michaelrommel/nightliner/images/nightliner-left-noacryl.png

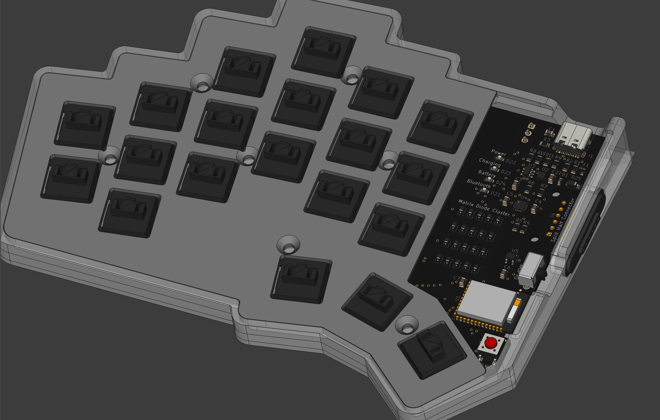
images/nightliner-left-noacryl.png
