michaelrommel/nightliner/images/nightliner-left-pcb-in-case.png

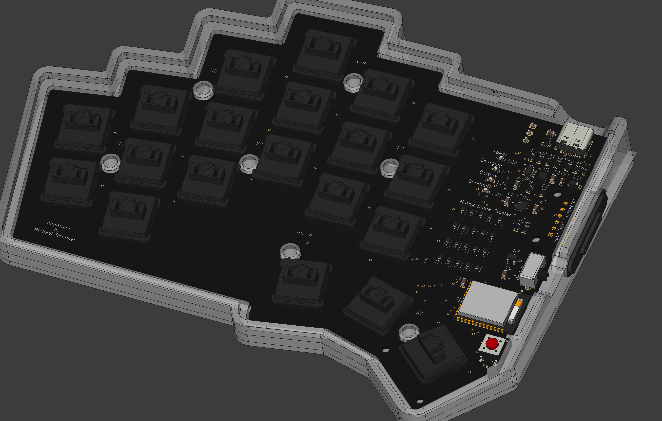
images/nightliner-left-pcb-in-case.png
