michaelrommel/nightliner/images/nightliner-left-pcb-underside.png

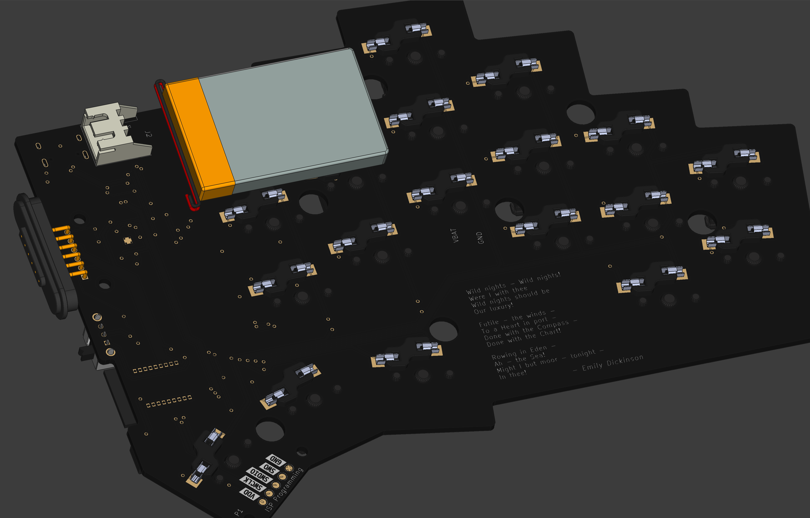
images/nightliner-left-pcb-underside.png
