michaelrommel/nightliner/3dmodels/pogo-connector-female-6-right.FCStd

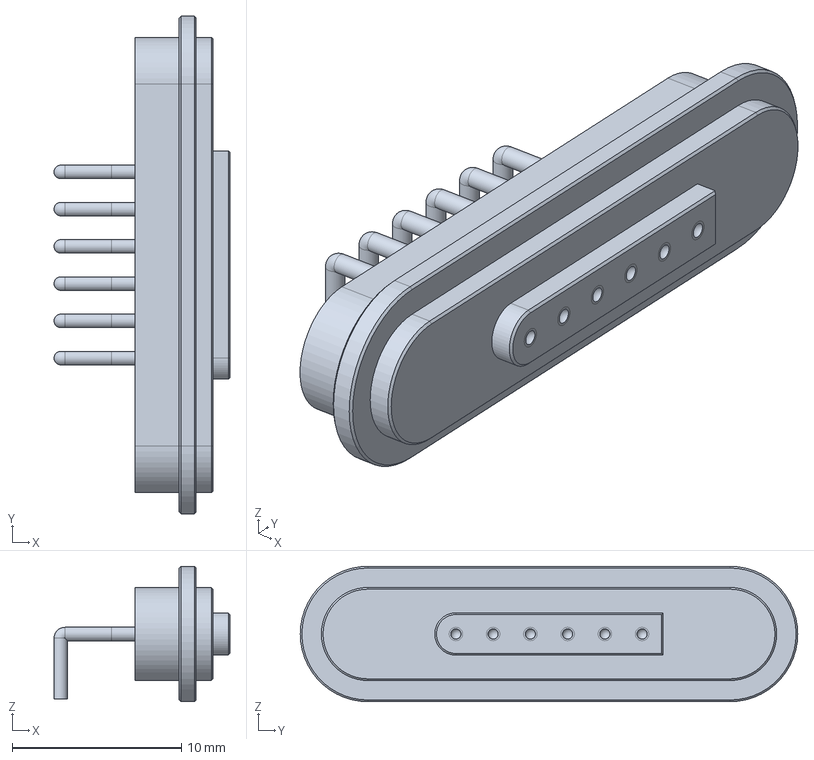
[picture p4: CAD file, 2023-11-07]
3dmodels/pogo-connector-female-6-right.FCStd
10.4 x 29.4 x 8.00 mm
