michaelrommel/nightliner/ergogen/stack_plate.dxf

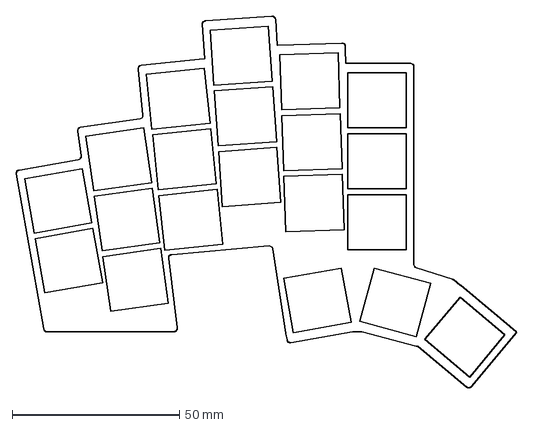
[picture p5: CAD file, 2023-10-26]
ergogen/stack_plate.dxf
149.8 x 111.2 mm
