michaelrommel/nightliner/nightliner-left/dxf/nightliner-User_2.dxf

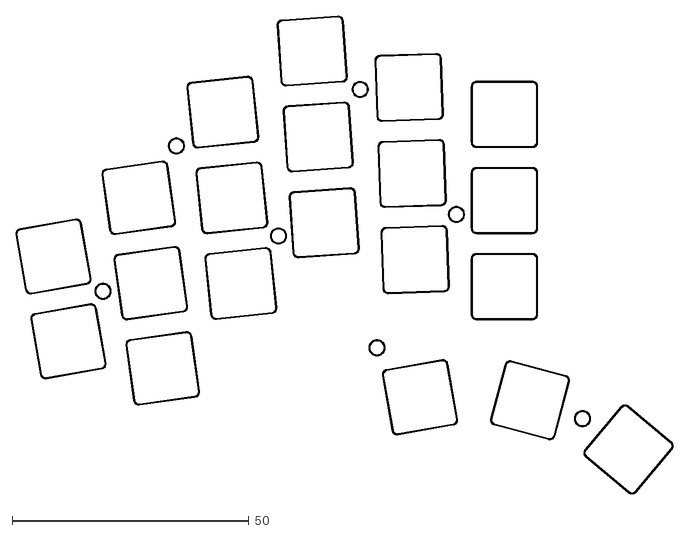
[picture p6: CAD file, 2023-12-03]
nightliner-left/dxf/nightliner-User_2.dxf
138.9 x 101.0
