michaelrommel/nightliner/nightliner-right/dxf/nightliner-User_3.dxf

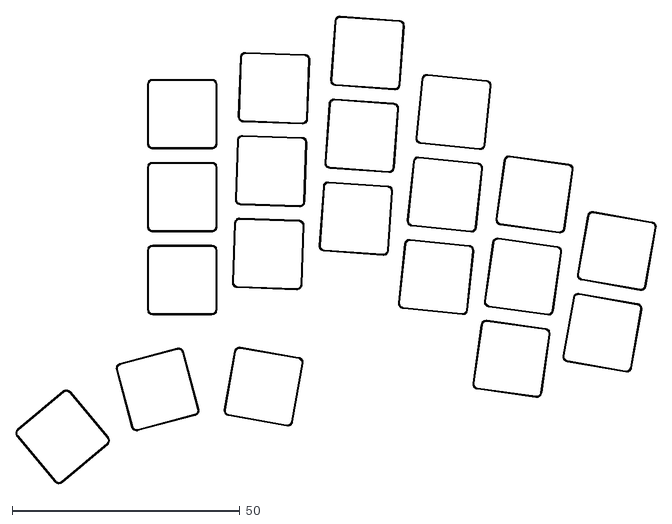
[picture p7: CAD file, 2023-11-23]
nightliner-right/dxf/nightliner-User_3.dxf
140.4 x 102.5
