michaelrommel/nightliner/3dmodels/Kailh_Choc_CPG135001D02-brown.step

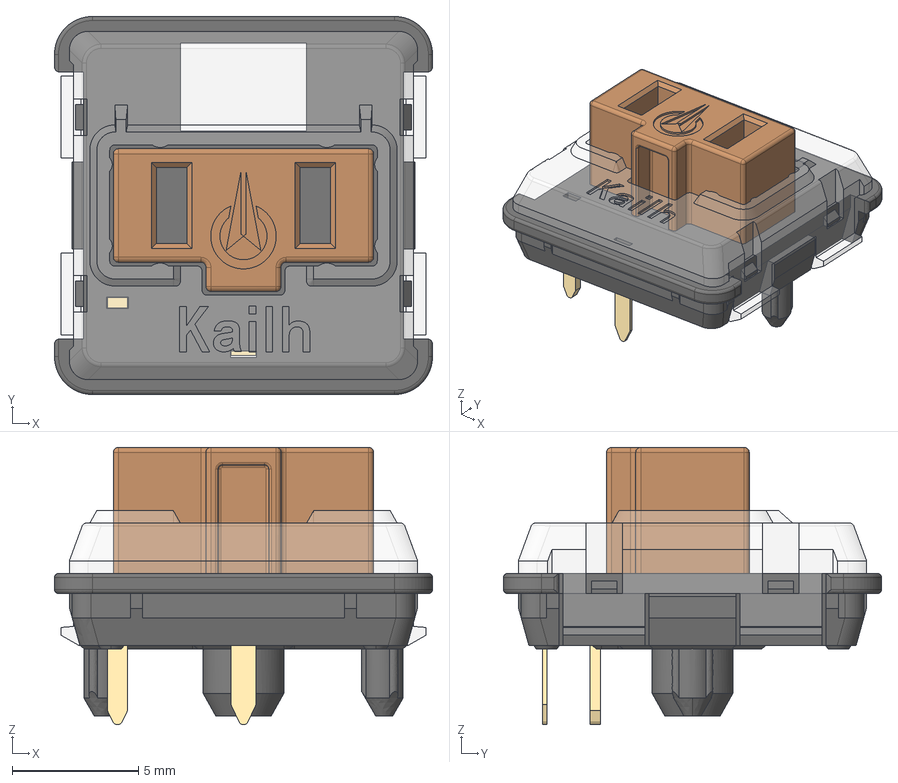
[picture p8: CAD file, 2023-11-07]
3dmodels/Kailh_Choc_CPG135001D02-brown.step
15.0 x 15.0 x 11.0 mm
Document x 2
Document001 x 2
Document006 x 2
Document007 x 2
Document008 x 2
