michaelrommel/nightliner/cad/Litio_523450.FCStd

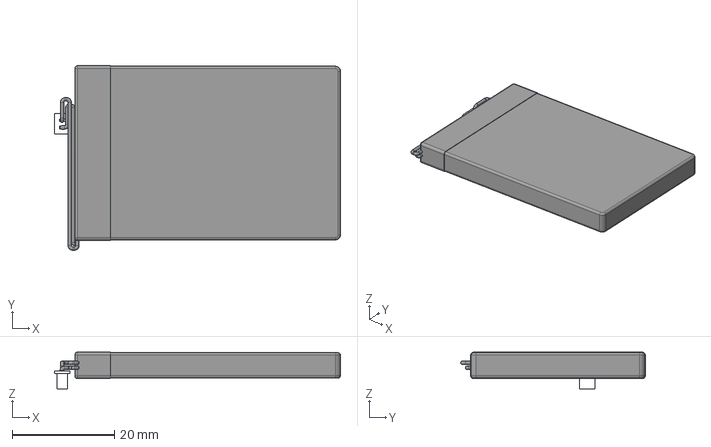
[picture p9: CAD file, 2023-11-04]
cad/Litio_523450.FCStd
56.0 x 36.2 x 7.20 mm
Conector
