michaelrommel/nightliner/ergogen/plate.dxf

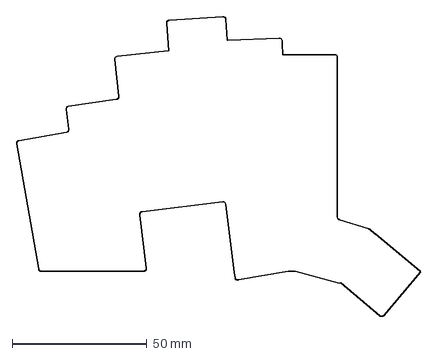
[picture p10: CAD file, 2023-10-26]
ergogen/plate.dxf
149.8 x 111.2 mm
