michaelrommel/nightliner/nightliner-left/dxf/nightliner-User_5.dxf

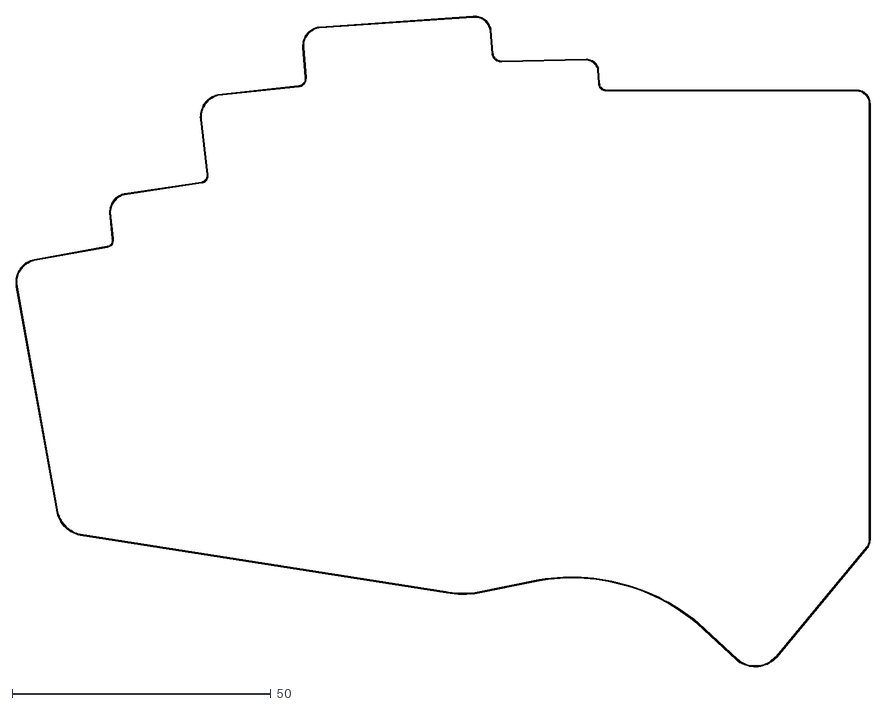
[picture p11: CAD file, 2023-11-23]
nightliner-left/dxf/nightliner-User_5.dxf
165.1 x 125.7
