michaelrommel/nightliner/nightliner-right/dxf/nightliner-User_Drawings.dxf

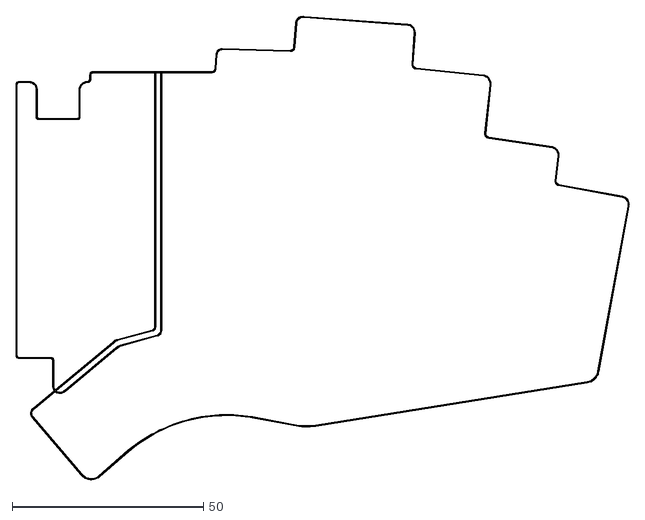
[picture p12: CAD file, 2023-11-23]
nightliner-right/dxf/nightliner-User_Drawings.dxf
160.3 x 121.1
