michaelrommel/nightliner/3dmodels/female-pogo-6pin-right.step

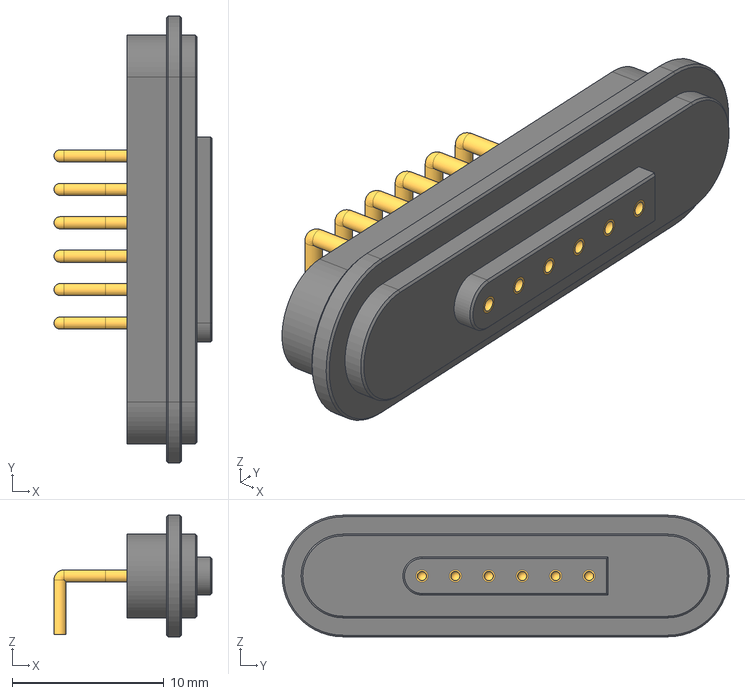
[picture p13: CAD file, 2023-11-04]
3dmodels/female-pogo-6pin-right.step
10.4 x 29.4 x 8.00 mm
female-pogo-6pin
AdditivePipe005
