michaelrommel/nightliner/cad/Litio_502540.FCStd

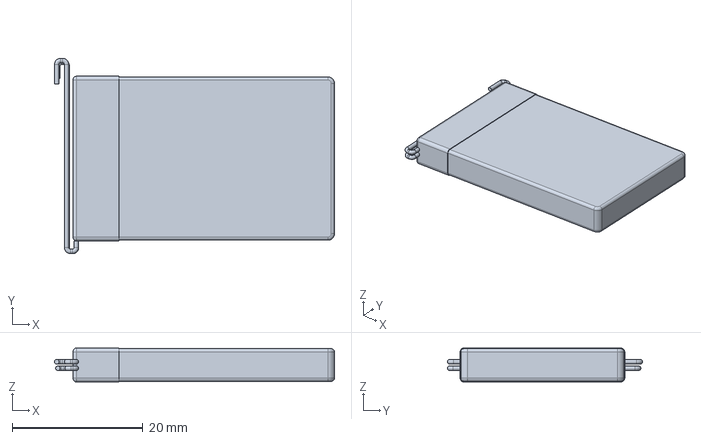
[picture p14: CAD file, 2023-11-04]
cad/Litio_502540.FCStd
42.8 x 29.9 x 5.20 mm
