michaelrommel/nightliner/ergogen/switchplate.dxf

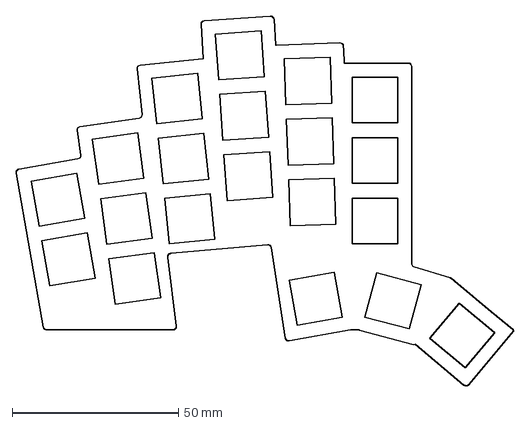
[picture p15: CAD file, 2023-10-26]
ergogen/switchplate.dxf
149.8 x 111.2 mm
