michaelrommel/nightliner/nightliner-left/dxf/nightliner-User_Drawings.dxf

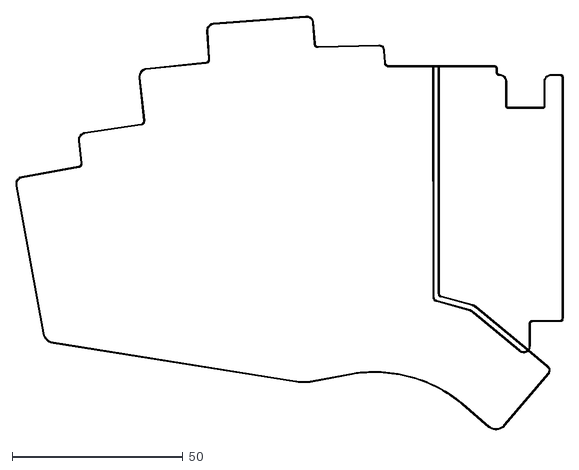
[picture p16: CAD file, 2023-11-23]
nightliner-left/dxf/nightliner-User_Drawings.dxf
160.3 x 121.1
