michaelrommel/nightliner/nightliner-right/dxf/nightliner-User_4.dxf

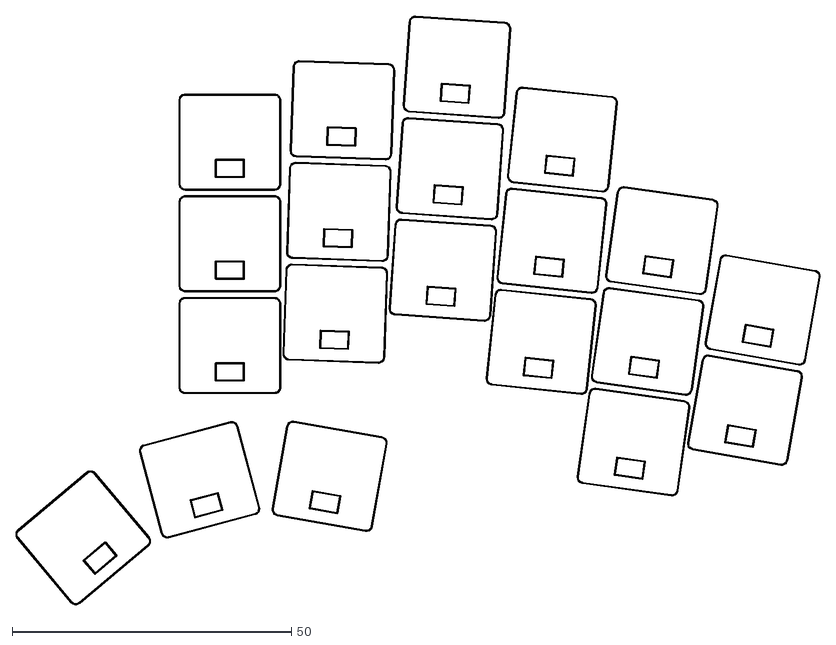
[picture p17: CAD file, 2023-11-23]
nightliner-right/dxf/nightliner-User_4.dxf
143.8 x 105.3
