michaelrommel/nightliner/cad/nightliner-Switchplate.3mf

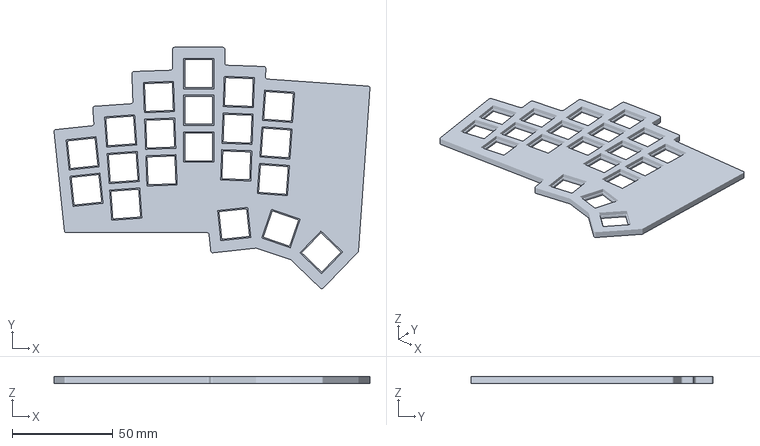
[picture p18: CAD file, 2023-10-25]
cad/nightliner-Switchplate.3mf
156.8 x 119.8 x 3.30 mm
