michaelrommel/nightliner/ergogen/switchplate_recess.dxf

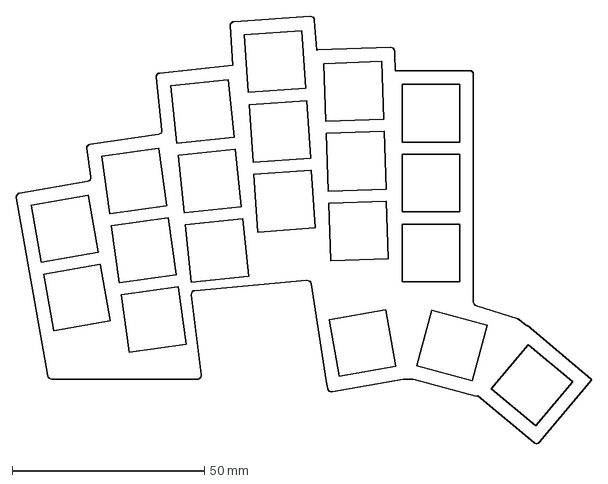
[picture p19: CAD file, 2023-10-26]
ergogen/switchplate_recess.dxf
149.8 x 111.2 mm
