michaelrommel/nightliner/nightliner-left/dxf/nightliner-User_Comments.dxf

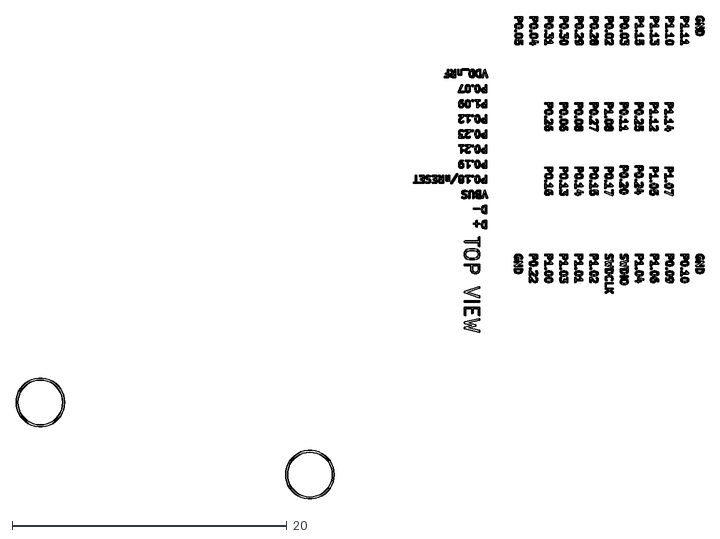
[picture p20: CAD file, 2023-11-14]
nightliner-left/dxf/nightliner-User_Comments.dxf
50.1 x 35.2
