michaelrommel/nightliner/nightliner-right/dxf/nightliner-User_2.dxf

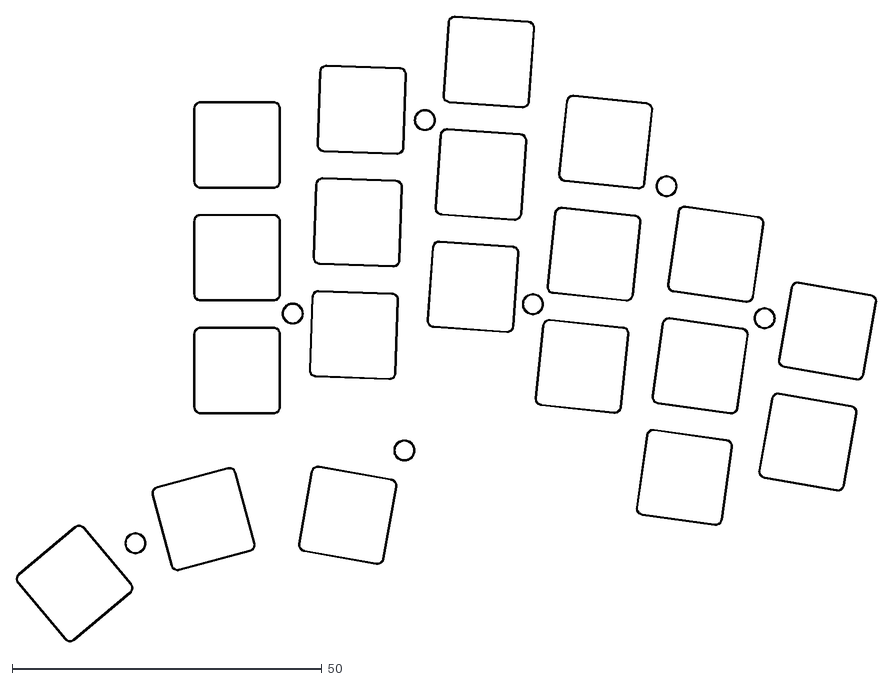
[picture p21: CAD file, 2023-11-23]
nightliner-right/dxf/nightliner-User_2.dxf
138.9 x 101.0
