michaelrommel/nightliner/ergogen/stack_pcb.dxf

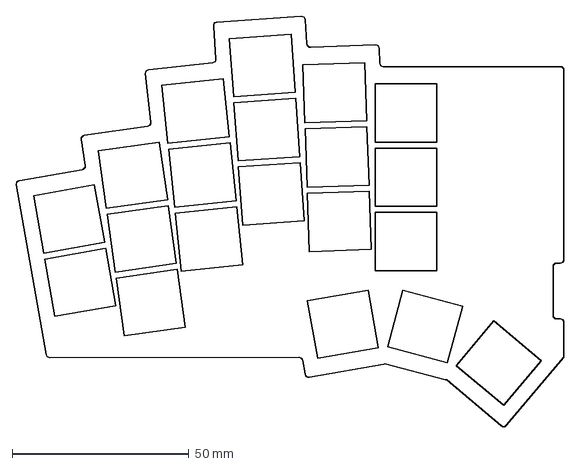
[picture p22: CAD file, 2023-10-25]
ergogen/stack_pcb.dxf
154.9 x 116.2 mm
