michaelrommel/nightliner/nightliner-left/dxf/nightliner-Edge_Cuts.dxf

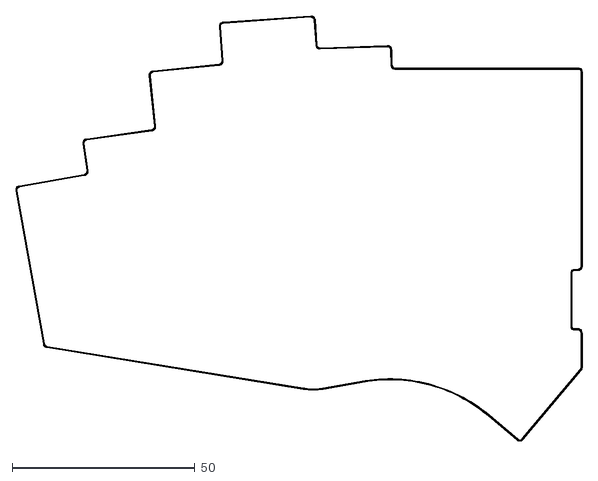
[picture p23: CAD file, 2023-11-14]
nightliner-left/dxf/nightliner-Edge_Cuts.dxf
155.0 x 116.3
