michaelrommel/nightliner/nightliner-right/dxf/nightliner-User_5.dxf

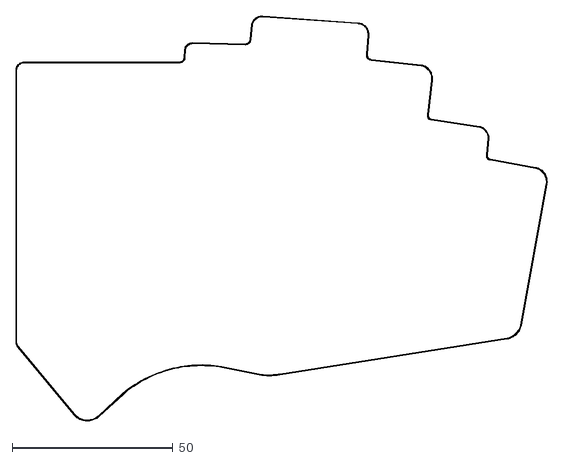
[picture p24: CAD file, 2023-11-23]
nightliner-right/dxf/nightliner-User_5.dxf
165.1 x 125.7
