michaelrommel/nightliner/ergogen/pcb.dxf

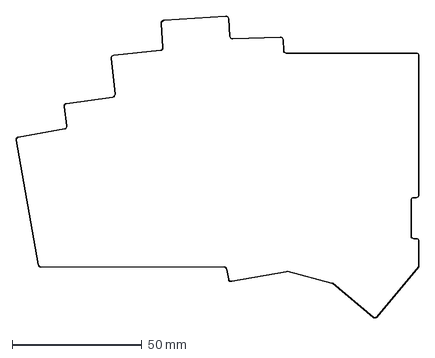
[picture p25: CAD file, 2023-10-25]
ergogen/pcb.dxf
154.9 x 116.2 mm
