michaelrommel/nightliner/nightliner-left/dxf/nightliner-User_1.dxf

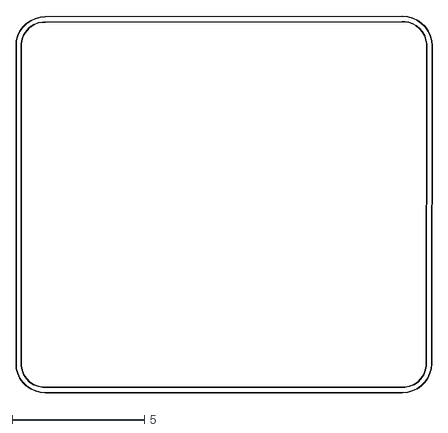
[picture p26: CAD file, 2023-11-04]
nightliner-left/dxf/nightliner-User_1.dxf
15.7 x 14.2
