michaelrommel/nightliner/nightliner-right/dxf/nightliner-Edge_Cuts.dxf

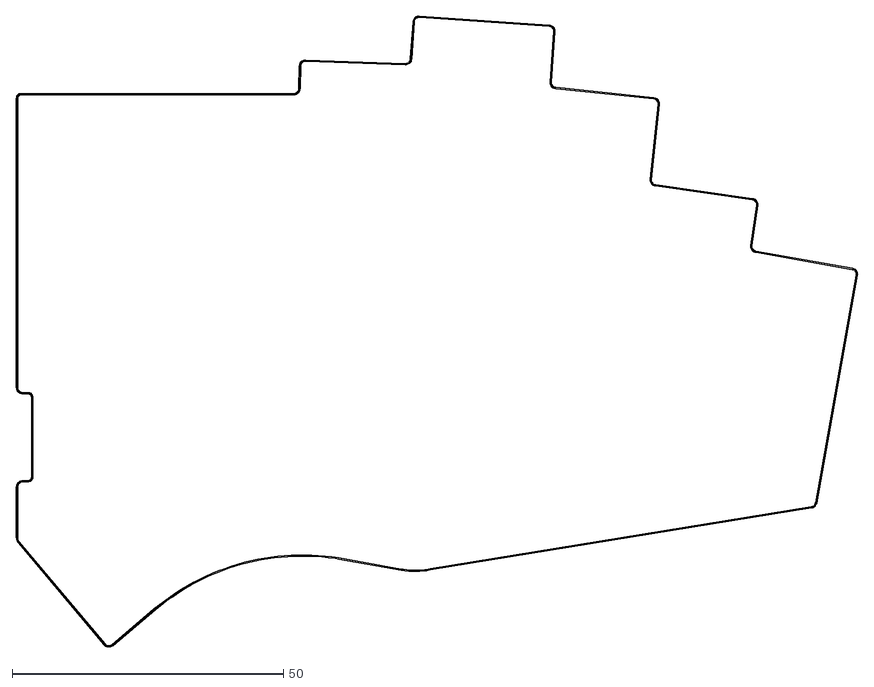
[picture p27: CAD file, 2023-11-14]
nightliner-right/dxf/nightliner-Edge_Cuts.dxf
155.0 x 116.3
