michaelrommel/nightliner/3dmodels/Choc.FCStd

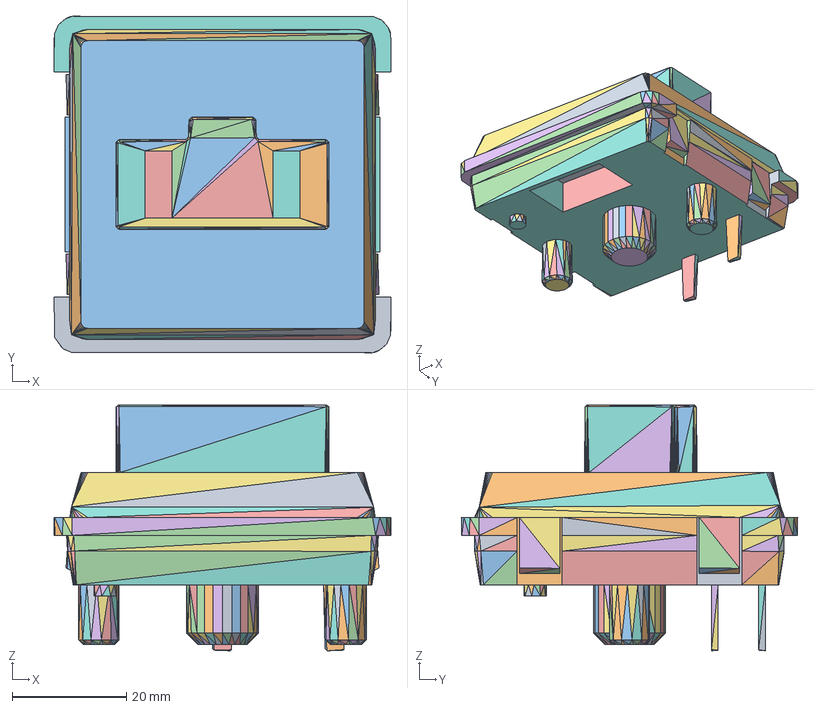
[picture p28: CAD file, 2023-10-30]
3dmodels/Choc.FCStd
59.1 x 59.0 x 43.1 mm
Component001 (Solid)001
Component001 (Solid)002
Component001 (Solid)003
Component001 (Solid)004
Component001 (Solid)005
Component001 (Solid)006
Component001 (Solid)007
Component001 (Solid)008
Component001 (Solid)009
Component001 (Solid)010
Component001 (Solid)011
Component001 (Solid)012
Component001 (Solid)013
Component001 (Solid)014
Component001 (Solid)015
Component001 (Solid)016
Component001 (Solid)017
Component001 (Solid)018
Component001 (Solid)019
Component001 (Solid)020
Component001 (Solid)021
Component001 (Solid)022
Component001 (Solid)023
Component001 (Solid)024
Component001 (Solid)025
Component001 (Solid)026
Component001 (Solid)027
Component001 (Solid)028
Component001 (Solid)029
Component001 (Solid)030
Component001 (Solid)031
Component001 (Solid)032
Component001 (Solid)033
Component001 (Solid)034
Component001 (Solid)035
Component001 (Solid)036
Component001 (Solid)037
Component001 (Solid)038
Component001 (Solid)039
Component001 (Solid)040
Component001 (Solid)041
Component001 (Solid)042
Component001 (Solid)043
Component001 (Solid)044
Component001 (Solid)045
Component001 (Solid)046
Component001 (Solid)047
Component001 (Solid)048
Component001 (Solid)049
Component001 (Solid)050
Component001 (Solid)051
Component001 (Solid)052
Component001 (Solid)053
Component001 (Solid)054
Component001 (Solid)055
Component001 (Solid)056
Component001 (Solid)057
Component001 (Solid)058
Component001 (Solid)059
Component001 (Solid)060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
