michaelrommel/nightliner/ergogen/keycaps.dxf

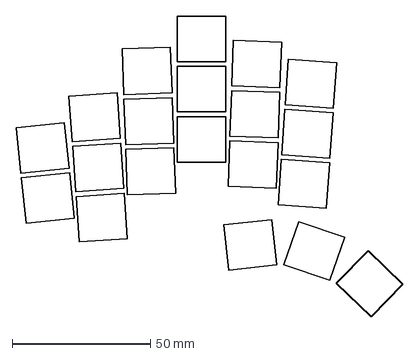
[picture p29: CAD file, 2023-10-25]
ergogen/keycaps.dxf
140.0 x 108.9 mm
