michaelrommel/nightliner/nightliner-left/dxf/nightliner-User_4.dxf

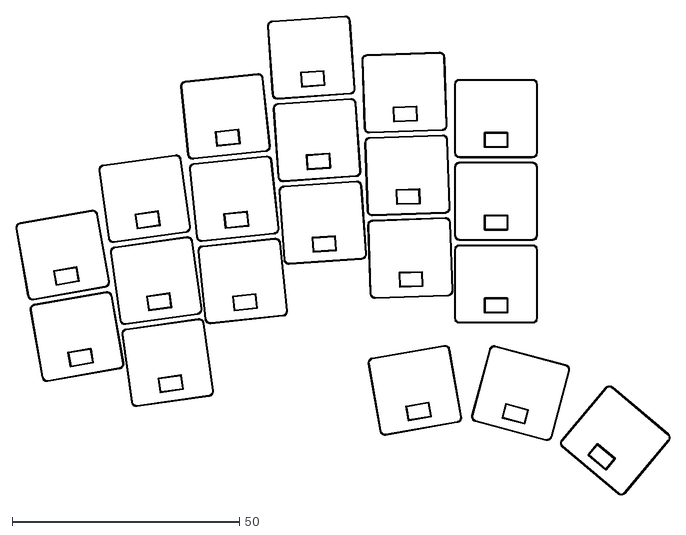
[picture p30: CAD file, 2023-11-04]
nightliner-left/dxf/nightliner-User_4.dxf
143.8 x 105.3
