michaelrommel/nightliner/nightliner-right/dxf/nightliner-User_Comments.dxf

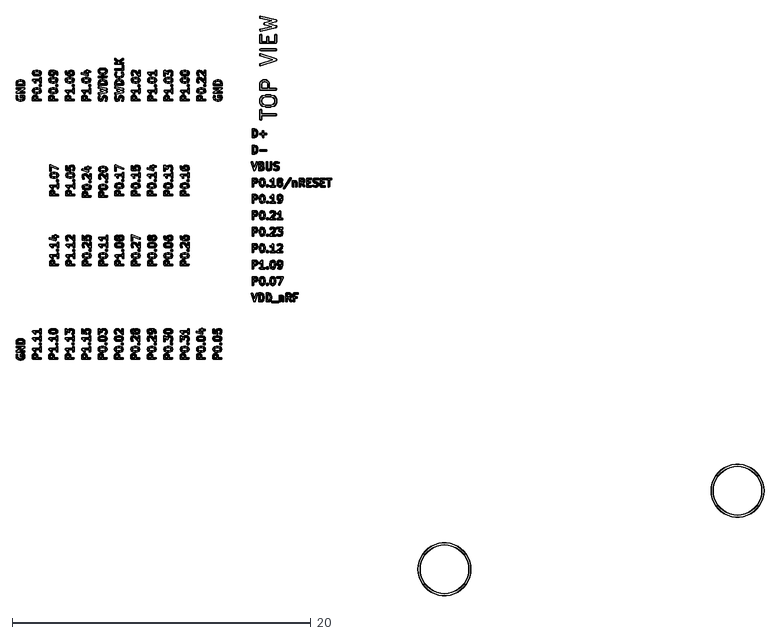
[picture p31: CAD file, 2023-11-14]
nightliner-right/dxf/nightliner-User_Comments.dxf
50.1 x 38.8
