michaelrommel/nightliner/3dmodels/Holyiot18010.step

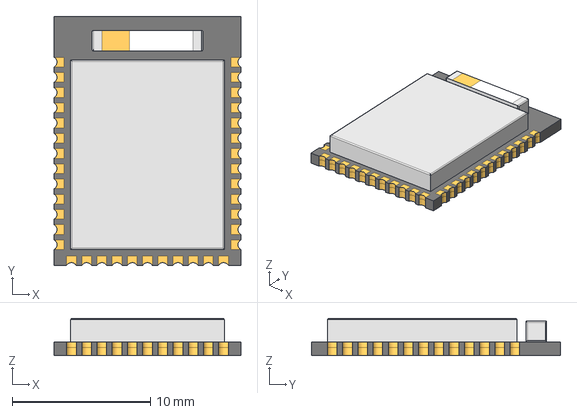
[picture p32: CAD file, 2023-10-30]
3dmodels/Holyiot18010.step
13.5 x 18.0 x 2.70 mm
