michaelrommel/nightliner/nightliner-left/dxf/nightliner-User_3.dxf

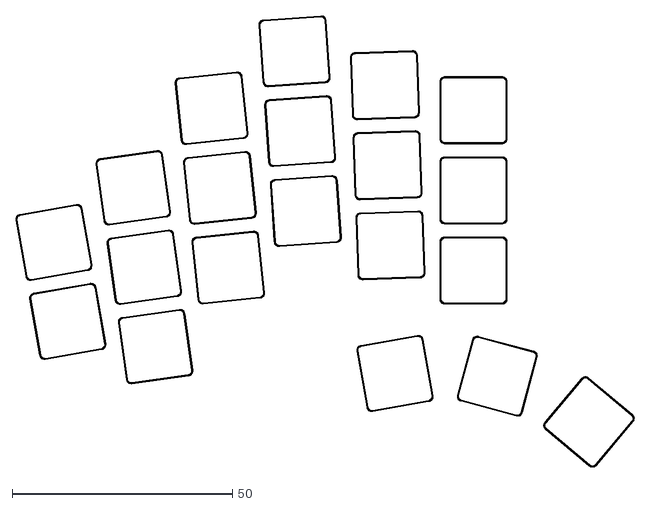
[picture p33: CAD file, 2023-11-04]
nightliner-left/dxf/nightliner-User_3.dxf
140.4 x 102.5
