michaelrommel/nightliner/nightliner-right/dxf/nightliner-User_1.dxf

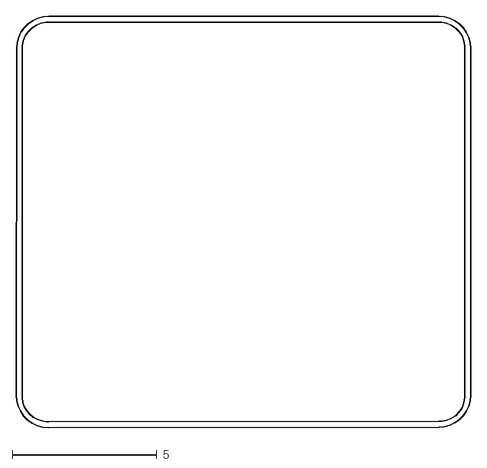
[picture p34: CAD file, 2023-11-07]
nightliner-right/dxf/nightliner-User_1.dxf
15.7 x 14.2
