michaelrommel/nightliner/3dmodels/Kailh_Choc_CPG135001D02.step

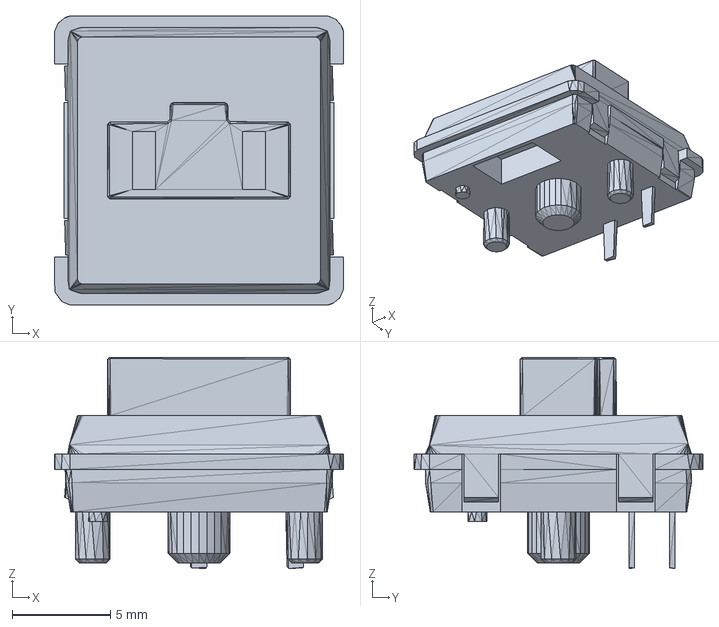
[picture p35: CAD file, 2023-10-30]
3dmodels/Kailh_Choc_CPG135001D02.step
14.8 x 14.7 x 10.8 mm
