michaelrommel/nightliner/3dmodels/Kailh_Hotswap_Socket_PG1350.step

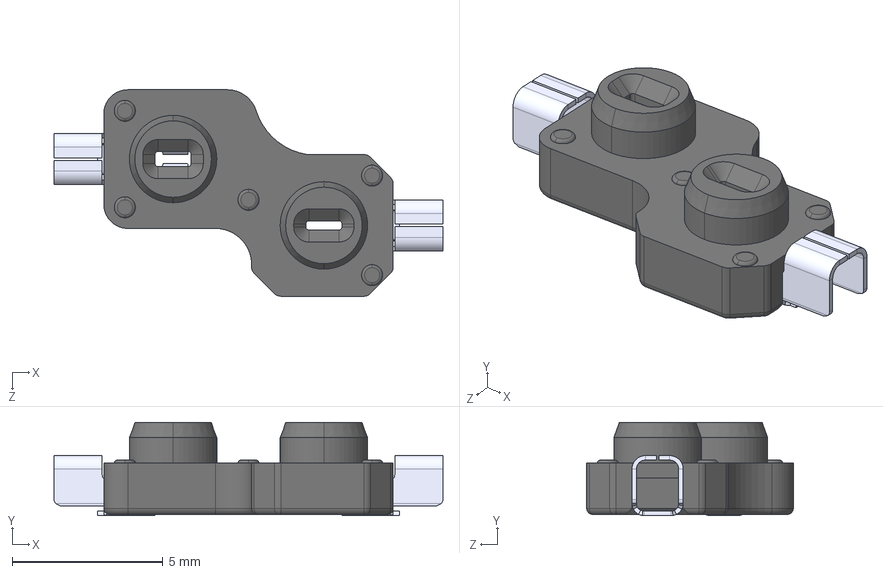
[picture p36: CAD file, 2023-10-30]
3dmodels/Kailh_Hotswap_Socket_PG1350.step
12.9 x 3.09 x 6.85 mm
pin x 2
socket
