michaelrommel/nightliner/3dmodels/3Pins SPDT switch SK-12D07 1P2T.iges

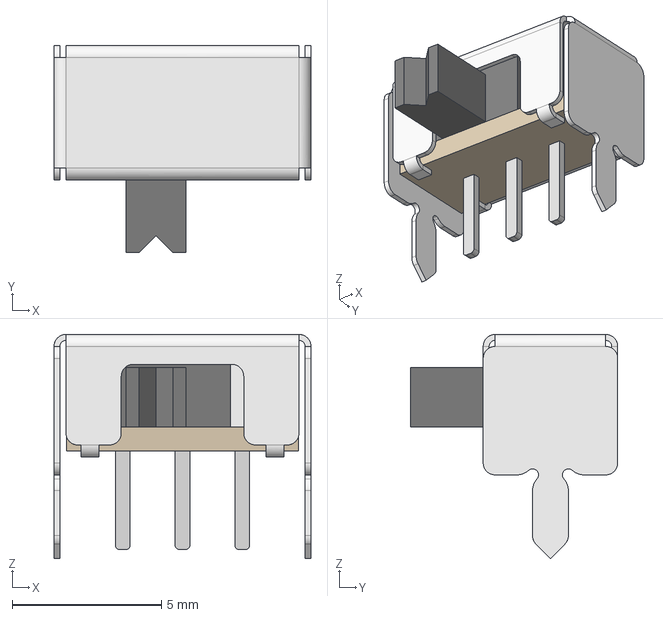
[picture p37: CAD file, 2023-10-30]
3dmodels/3Pins SPDT switch SK-12D07 1P2T.iges
8.60 x 6.94 x 7.50 mm
