michaelrommel/nightliner/(list of files, cad)

Other CAD files:
cad/nightliner-case-right-rounded.FCStd
3dmodels/LiPo_502540.step
3dmodels/pogo-connector-female-6-left.FCStd
3dmodels/female-pogo-6pin-left.step
3dmodels/Kailh_Choc_CPG135001D02-somewhatold.step
3dmodels/Kailh_Choc_CPG135001D02-brown.FCStd
3dmodels/Kailh_Choc_CPG135001D02-old.step
nightliner-left/dxf/nightliner-B_Silkscreen.dxf
nightliner-left/dxf/nightliner-F_Silkscreen.dxf
nightliner-right/dxf/nightliner-B_Silkscreen.dxf
nightliner-right/dxf/nightliner-F_Silkscreen.dxf
