michaelrommel/nightliner/images/nightliner-assembly-instruction-example.png

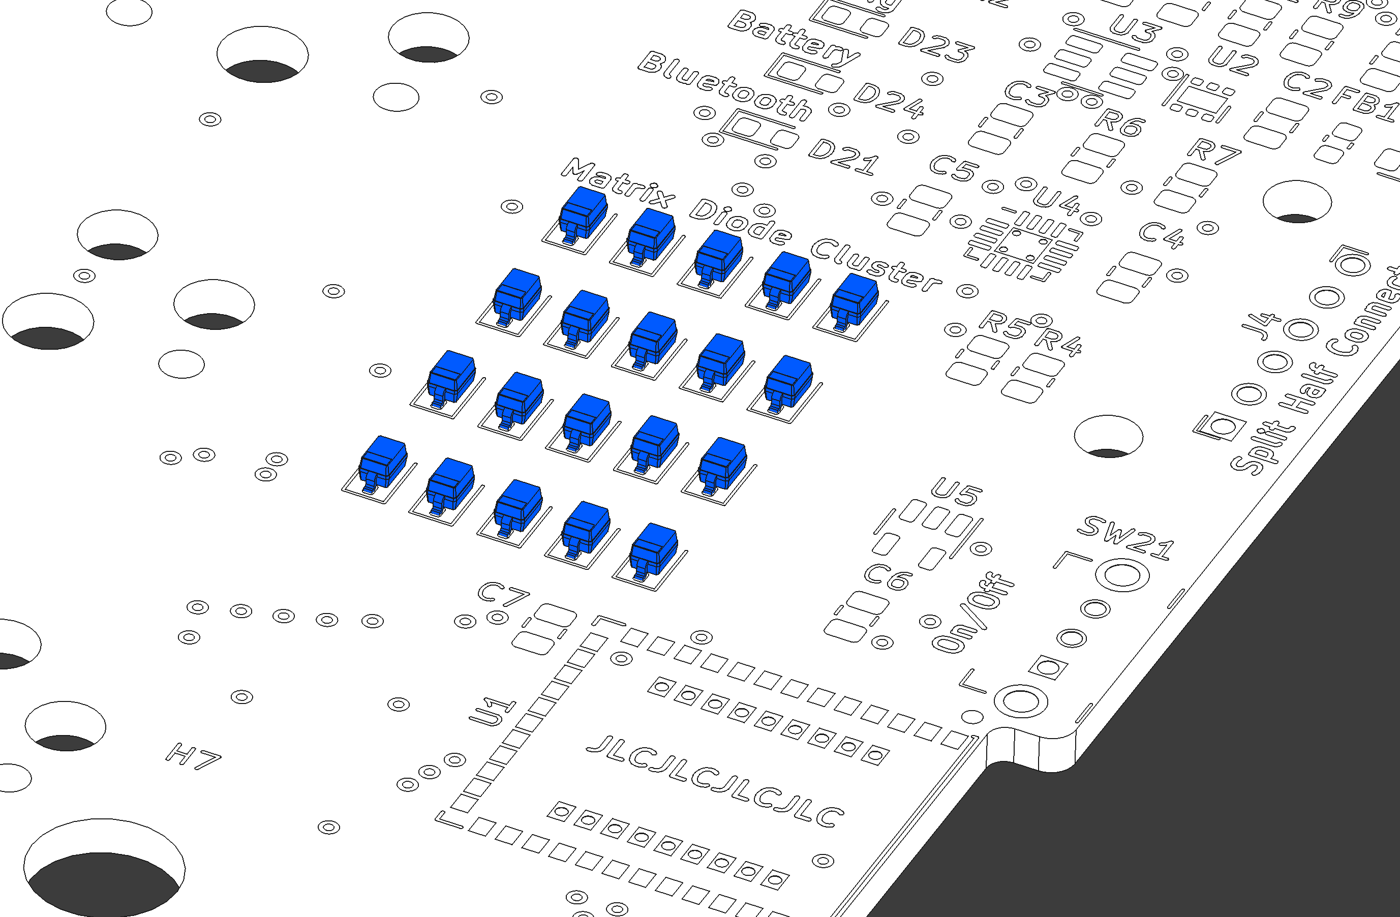
images/nightliner-assembly-instruction-example.png
