michaelrommel/nightliner/renderings/test-1.jpg

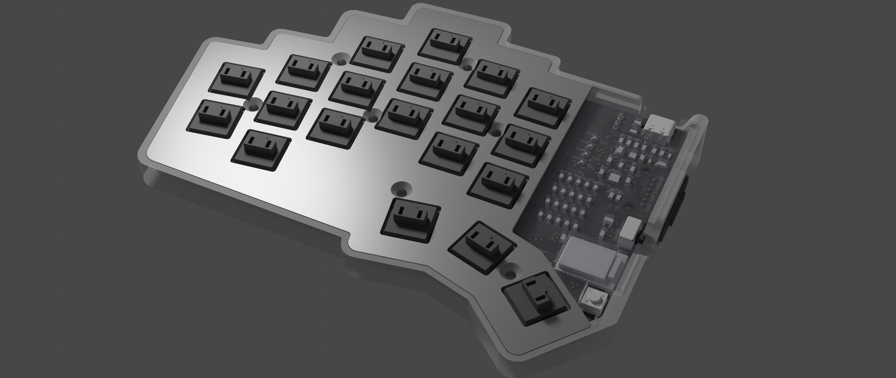
renderings/test-1.jpg
