michaelrommel/nightliner/nightliner-left/nightliner.kicad_pcb

## KiCad design nightliner-left/nightliner.kicad_pcb (2023-12-03)

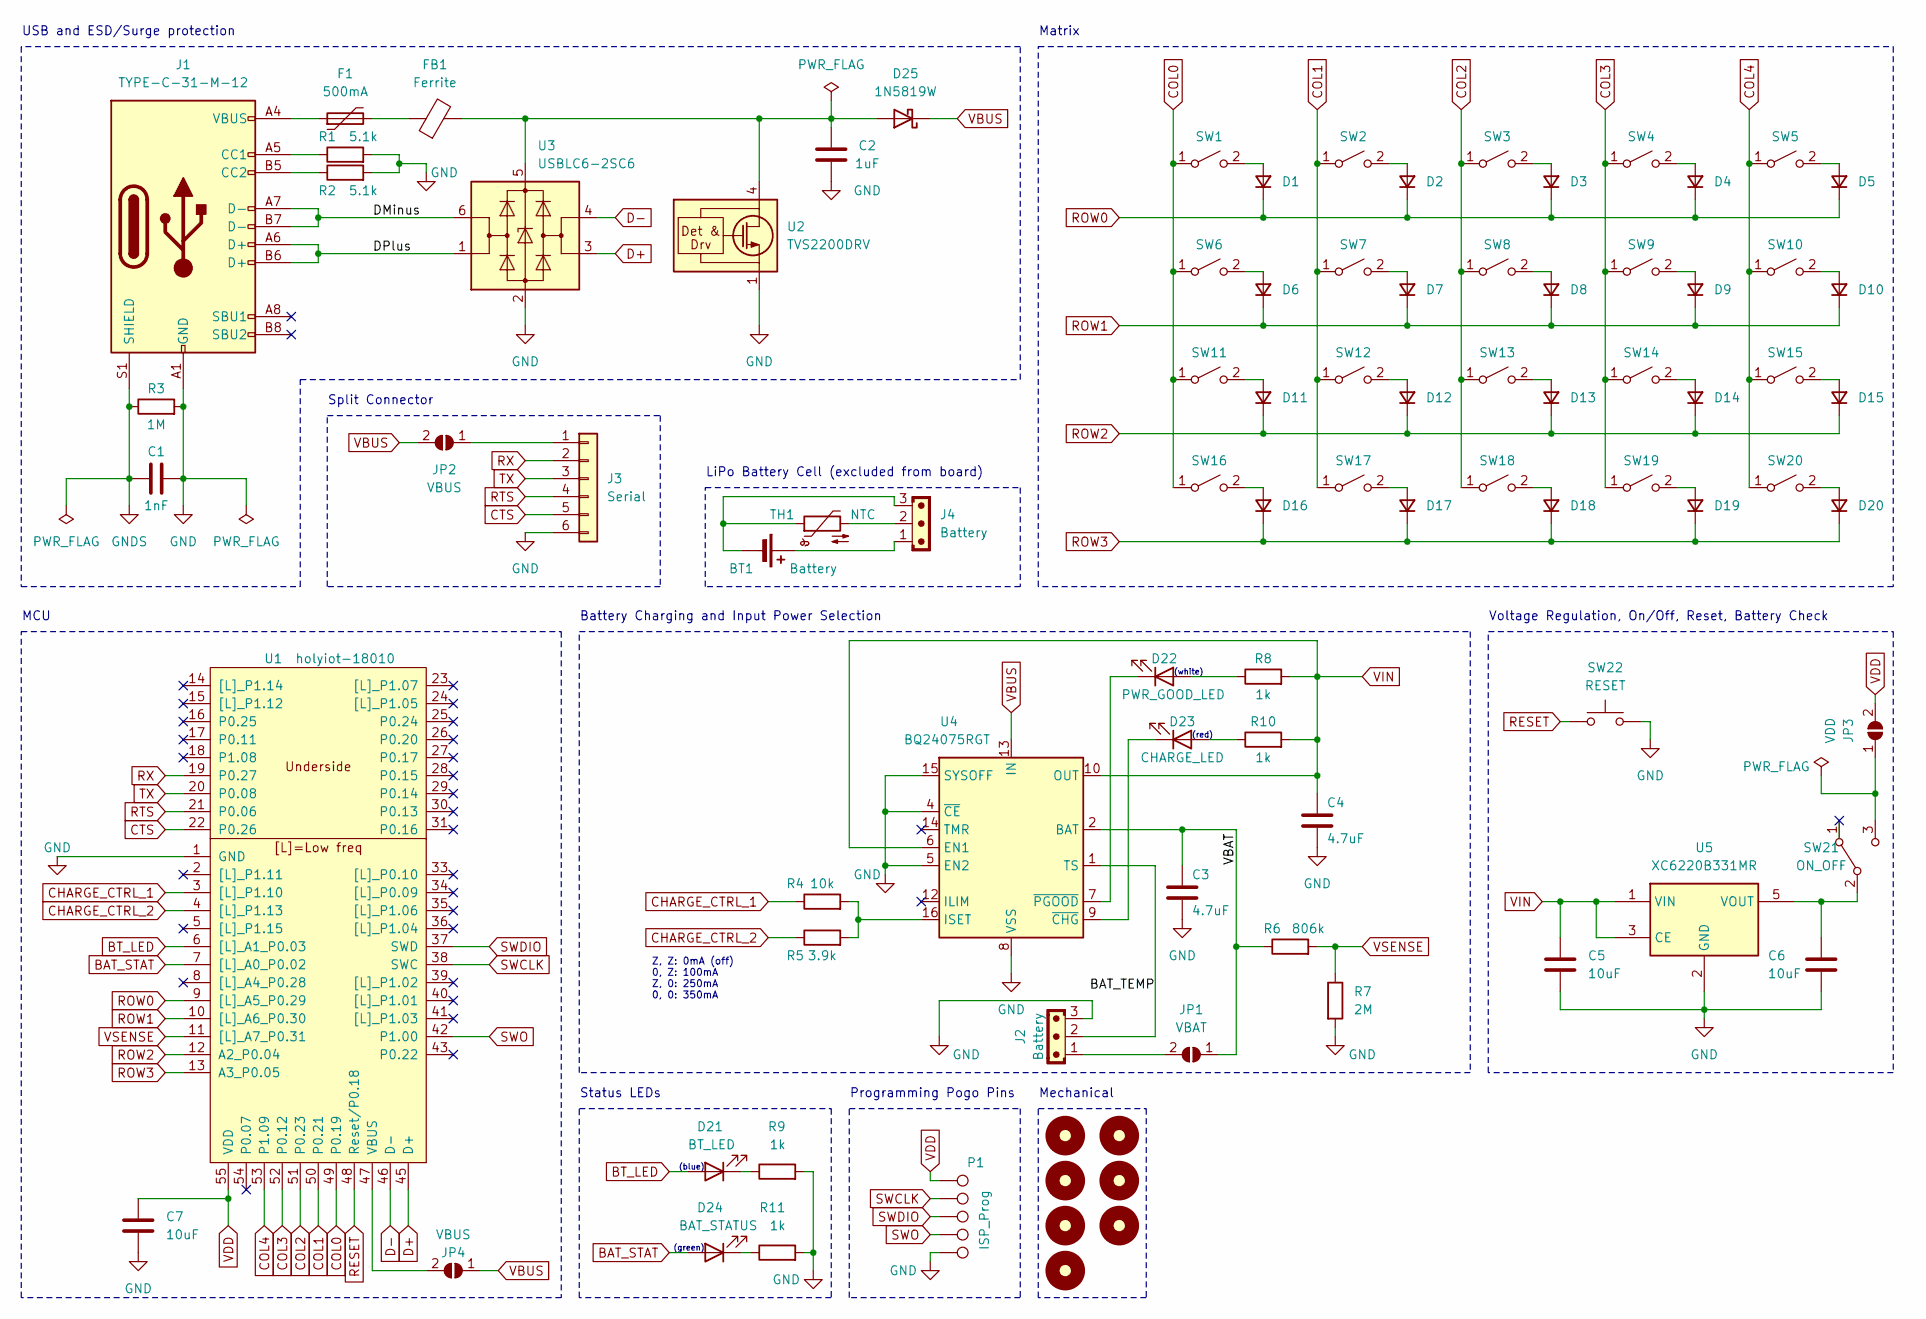
[picture p40: schematic nightliner.kicad_sch, nightliner - a split wireless keyboard]

Parts:
BT1: Battery
C1: 1nF; C_0805_2012Metric
C2: 1uF; C_0805_2012Metric
C3, C4: 4.7uF; C_0805_2012Metric
C5, C6, C7: 10uF; C_0805_2012Metric
D1, D2, D3, D4, D5, D6, D7, D8, D9, D10, D11, D12, D13, D14, D15, D16, D17, D18, D19, D20: D_Small; D_SOD-323
D21: BT_LED; LED_0603_1608Metric; PartNumber LTST-C194TBKT; LCSCNumber C575417
D22: PWR_GOOD_LED; LED_0603_1608Metric; PartNumber LTW-C194TS5; LCSCNumber C575432
D23: CHARGE_LED; LED_0603_1608Metric; PartNumber LTST-C194KRKT; LCSCNumber C913101
D24: BAT_STATUS; LED_0603_1608Metric; PartNumber LTST-C194KGKT; LCSCNumber C913102
D25: 1N5819W; D_SOD-123
F1: 500mA; Fuse_0603_1608Metric; PartNumber BSMD0603-050-6V; LCSCNumber C883095
FB1: Ferrite; C_0603_1608Metric; PartNumber BLM18PG121SN1D; LCSCNumber C14709
H1: Standoff_6mm_M3; StandOff_6mm_M3
H2, H3, H4, H5, H6, H7: MountingHole_M3; StandOff_6mm_M3
J1: TYPE-C-31-M-12; PartNumber TYPE-C-31-M-12; LCSCNumber C165948
J2: Battery; JST_XH_S3B-XH-A-1_1x03_P2.50mm_Horizontal
J3: Serial; MagConn_6pin_left
J4: Battery; JST_EH_B3B-EH-A_1x03_P2.50mm_Vertical
JP1: VBAT; SolderJumper-2_P1.3mm_Open_RoundedPad1.0x1.5mm
JP2, JP4: VBUS; SolderJumper-2_P1.3mm_Open_RoundedPad1.0x1.5mm
JP3: VDD; SolderJumper-2_P1.3mm_Open_RoundedPad1.0x1.5mm
P1: ISP_Prog; ISP_Programming_Pads
R1, R2: 5.1k; R_0805_2012Metric
R3: 1M; R_0805_2012Metric
R4: 10k; R_0805_2012Metric
R5: 3.9k; R_0805_2012Metric
R6: 806k; R_0805_2012Metric
R7: 2M; R_0805_2012Metric
R8, R9, R10, R11: 1k; R_0805_2012Metric
SW1: pinky_top; Kailh_Choc_CPG135001D02_Hotswap
SW2: ring_top; Kailh_Choc_CPG135001D02_Hotswap
SW3: middle_top; Kailh_Choc_CPG135001D02_Hotswap
SW4: index_top; Kailh_Choc_CPG135001D02_Hotswap
SW5: inner_top; Kailh_Choc_CPG135001D02_Hotswap
SW6: pinky_home; Kailh_Choc_CPG135001D02_Hotswap
SW7: ring_home; Kailh_Choc_CPG135001D02_Hotswap
SW8: middle_home; Kailh_Choc_CPG135001D02_Hotswap
SW9: index_home; Kailh_Choc_CPG135001D02_Hotswap
SW10: inner_home; Kailh_Choc_CPG135001D02_Hotswap
SW11: pinky_bottom; Kailh_Choc_CPG135001D02_Hotswap
SW12: ring_bottom; Kailh_Choc_CPG135001D02_Hotswap
SW13: middle_bottom; Kailh_Choc_CPG135001D02_Hotswap
SW14: index_bottom; Kailh_Choc_CPG135001D02_Hotswap
SW15: inner_bottom; Kailh_Choc_CPG135001D02_Hotswap
SW16: outer_top; Kailh_Choc_CPG135001D02_Hotswap
SW17: outer_home; Kailh_Choc_CPG135001D02_Hotswap
SW18: near_thumb; Kailh_Choc_CPG135001D02_Hotswap
SW19: home_thumb; Kailh_Choc_CPG135001D02_Hotswap
SW20: far_thumb; Kailh_Choc_CPG135001D02_Hotswap
SW21: ON_OFF; SW_ROCPU_SK-12D07-5_SPDT_Angled
SW22: RESET; SW_Push_1P1T_NO_CK_KSC4xxJ
TH1: NTC
U1: holyiot-18010; HOLYIOT-18010-UndersidePins-SMD
U2: TVS2200DRV; WSON-6-1EP_2x2mm_P0.65mm_EP1x1.6mm
U3: USBLC6-2SC6; SOT-23-6
U4: BQ24075RGT; VQFN-16-1EP_3x3mm_P0.5mm_EP1.6x1.6mm_ThermalVias
U5: XC6220B331MR; SOT-23-5

Connections:
/BAT_TEMP: J2.2, U4.1 (TS)
/DMinus: J1.A7 (D-), J1.B7 (D-), U3.6 (I/O1)
/DPlus: J1.A6 (D+), J1.B6 (D+), U3.1 (I/O1)
/VBAT: C3.1, JP1.1 (A), R6.1, U4.2 (BAT), U4.3 (BAT)
BAT_STAT: D24.2 (A), U1.7 ([L]_A0_P0.02)
BT_LED: D21.2 (A), U1.6 ([L]_A1_P0.03)
CHARGE_CTRL_1: R4.1, U1.3 ([L]_P1.10)
CHARGE_CTRL_2: R5.1, U1.4 ([L]_P1.13)
COL0: SW1.1 (A), SW6.1 (A), SW11.1 (A), SW16.1 (A), U1.49 (P0.19)
COL1: SW2.1 (A), SW7.1 (A), SW12.1 (A), SW17.1 (A), U1.50 (P0.21)
COL2: SW3.1 (A), SW8.1 (A), SW13.1 (A), SW18.1 (A), U1.51 (P0.23)
COL3: SW4.1 (A), SW9.1 (A), SW14.1 (A), SW19.1 (A), U1.52 (P0.12)
COL4: SW5.1 (A), SW10.1 (A), SW15.1 (A), SW20.1 (A), U1.53 (P1.09)
CTS: J3.5, U1.22 (P0.26)
D+: U1.45 (D+), U3.3 (I/O2)
D-: U1.46 (D-), U3.4 (I/O2)
GND: C1.2, C2.1, C3.2, C4.2, C5.2, C6.2, C7.2, J1.A1 (GND), J1.A12 (GND), J1.B1 (GND), J1.B12 (GND), J2.3, J3.6, P1.5 (GND), R1.2, R2.2, R3.2, R7.2, R9.2, R11.2, SW22.2, U1.1 (GND), U1.32 (GND), U1.44 (GND), U2.1 (GND), U2.2 (GND), U2.3 (GND), U2.7 (GND), U3.2 (GND), U4.4 (~CE), U4.5 (EN2), U4.8 (VSS), U4.15 (SYSOFF), U4.17 (VSS), U5.2 (GND)
GNDS: C1.1, J1.S1 (SHIELD), R3.1
unnamed: BT1.1 (+), J4.1
unnamed: BT1.2 (-), J4.3, TH1.1
unnamed: D1.2 (A), SW1.2 (B)
unnamed: D2.2 (A), SW2.2 (B)
unnamed: D3.2 (A), SW3.2 (B)
unnamed: D4.2 (A), SW4.2 (B)
unnamed: D5.2 (A), SW5.2 (B)
unnamed: D6.2 (A), SW6.2 (B)
unnamed: D7.2 (A), SW7.2 (B)
unnamed: D8.2 (A), SW8.2 (B)
unnamed: D9.2 (A), SW9.2 (B)
unnamed: D10.2 (A), SW10.2 (B)
unnamed: D11.2 (A), SW11.2 (B)
unnamed: D12.2 (A), SW12.2 (B)
unnamed: D13.2 (A), SW13.2 (B)
unnamed: D14.2 (A), SW14.2 (B)
unnamed: D15.2 (A), SW15.2 (B)
unnamed: D16.2 (A), SW16.2 (B)
unnamed: D17.2 (A), SW17.2 (B)
unnamed: D18.2 (A), SW18.2 (B)
unnamed: D19.2 (A), SW19.2 (B)
unnamed: D20.2 (A), SW20.2 (B)
unnamed: D21.1 (K), R9.1
unnamed: D22.2 (A), R8.1
unnamed: D22.1 (K), U4.7 (~PGOOD)
unnamed: D23.2 (A), R10.1
unnamed: D23.1 (K), U4.9 (~CHG)
unnamed: D24.1 (K), R11.1
unnamed: C2.2, D25.2 (A), FB1.2, U2.4 (IN), U2.5 (IN), U2.6 (IN), U3.5 (VBUS)
unnamed: F1.1, J1.A4 (VBUS), J1.A9 (VBUS), J1.B4 (VBUS), J1.B9 (VBUS)
unnamed: F1.2, FB1.1
unnamed: J1.A5 (CC1), R1.1
unnamed: J1.B5 (CC2), R2.1
unnamed: J3.1, JP2.1 (A)
unnamed: J4.2, TH1.2
unnamed: J2.1, JP1.2 (B)
unnamed: JP3.1 (A), SW21.3 (C)
unnamed: JP4.2 (B), U1.47 (VBUS)
unnamed: C6.1, SW21.2 (B), U5.5 (VOUT)
unnamed: R4.2, R5.2, U4.16 (ISET)
RESET: SW22.1, U1.48 (Reset/P0.18)
ROW0: D1.1 (K), D2.1 (K), D3.1 (K), D4.1 (K), D5.1 (K), U1.9 ([L]_A5_P0.29)
ROW1: D6.1 (K), D7.1 (K), D8.1 (K), D9.1 (K), D10.1 (K), U1.10 ([L]_A6_P0.30)
ROW2: D11.1 (K), D12.1 (K), D13.1 (K), D14.1 (K), D15.1 (K), U1.12 (A2_P0.04)
ROW3: D16.1 (K), D17.1 (K), D18.1 (K), D19.1 (K), D20.1 (K), U1.13 (A3_P0.05)
RTS: J3.4, U1.21 (P0.06)
RX: J3.2, U1.19 (P0.27)
SWCLK: P1.2 (SWCLK), U1.38 (SWC)
SWDIO: P1.3 (SWDIO), U1.37 (SWD)
SWO: P1.4 (SWO), U1.42 (P1.00)
TX: J3.3, U1.20 (P0.08)
VBUS: D25.1 (K), JP2.2 (B), JP4.1 (A), U4.13 (IN)
VDD: C7.1, JP3.2 (B), P1.1 (VDD), U1.55 (VDD)
VIN: C4.1, C5.1, R8.2, R10.2, U4.6 (EN1), U4.10 (OUT), U4.11 (OUT), U5.1 (VIN), U5.3 (CE)
VSENSE: R6.2, R7.1, U1.11 ([L]_A7_P0.31)

Notes on the sheet:
Programming Pogo Pins
Mechanical
Battery Charging and Input Power Selection
Status LEDs
Voltage Regulation, On/Off, Reset, Battery Check
Split Connector
MCU
(red)
Z, Z: 0mA (off) 0, Z: 100mA Z, 0: 250mA 0, 0: 350mA
Matrix
(green)
(white)
LiPo Battery Cell (excluded from board)
(blue)
USB and ESD/Surge protection

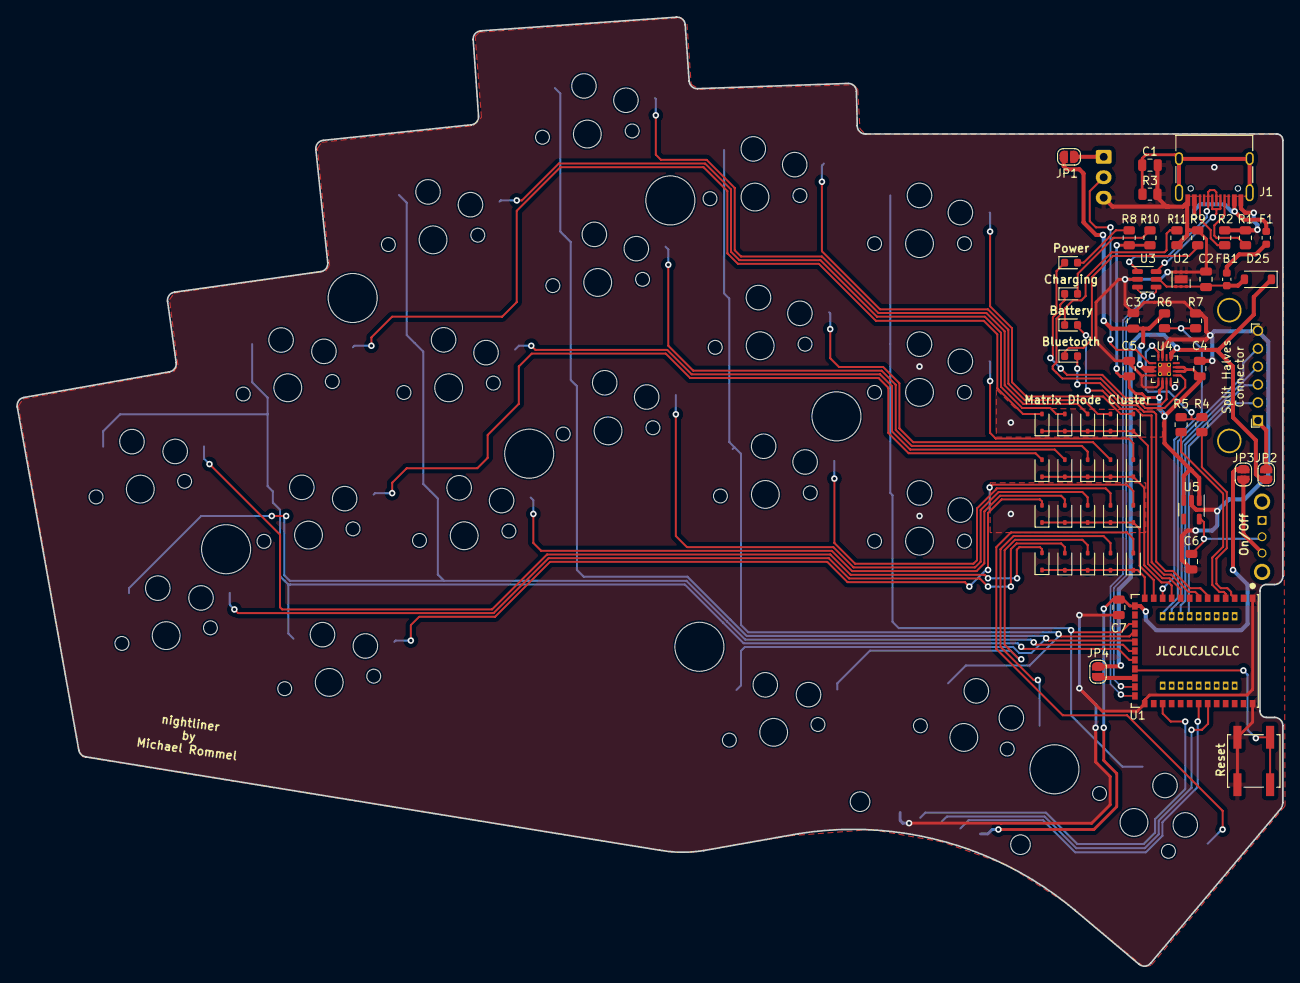
[picture p41: board nightliner.kicad_pcb from above]

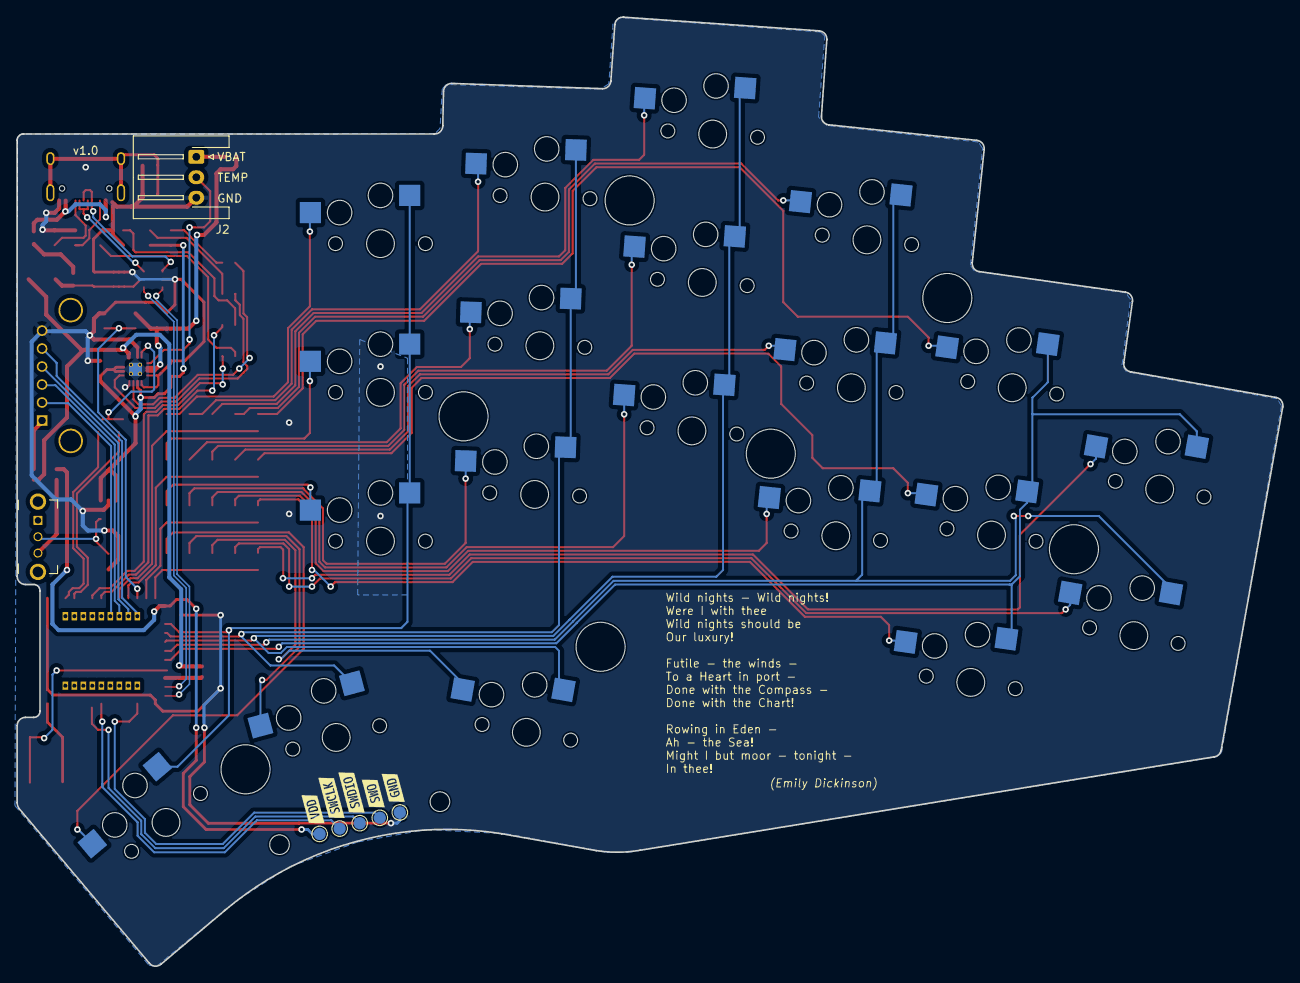
[picture p42: board nightliner.kicad_pcb from below]

Board: 2 copper layers, 154.8 x 116.1 mm, 87 parts (3 on the bottom side), 70 nets.
