michaelrommel/nightliner/ergogen/canonical.yaml

matrix_outer_home:
  x: -3.1603968
  'y': 17.9235011
  r: 10
  meta:
    stagger: 0
    spread: 18
    splay: 0
    origin:
      - 0
      - 0
    orient: 0
    shift:
      - 0
      - -0.0
    rotate: 0
    width: 17.5
    height: 16.5
    padding: 18.2
    autobind: 10
    skip: false
    asym: both
    colrow: outer_home
    name: matrix_outer_home
    bind:
      - 5
      - 5
      - 5
      - 5
    zone: &ref_1
      key:
        spread: 1mx
        padding: 1my
      columns:
        outer: &ref_0
          rows:
            top:
              shift:
                - 0
                - 0
            home:
              shift:
                - 0
                - '-0.0my'
            bottom:
              skip: true
          key: {}
          name: outer
        pinky: &ref_2
          key:
            splay: -2
            stagger: 0.5my
            spread: 1mx + 0.65
          rows:
            top:
              shift:
                - 0
                - 0
            home:
              shift:
                - 0
                - 0
            bottom:
              shift:
                - 0
                - 0
          name: pinky
        ring: &ref_3
          key:
            splay: -2
            stagger: 0.85my
            spread: 1mx + 0.85
          rows: {}
          name: ring
        middle: &ref_4
          key:
            splay: -2
            stagger: 0.60my
            spread: 1mx + 0.85
          rows: {}
          name: middle
        index: &ref_5
          key:
            splay: -2
            stagger: '-0.5my'
            spread: 1mx + 0.65
          rows: {}
          name: index
        inner: &ref_6
          key:
            splay: -2
            stagger: '-0.35my'
            spread: 1mx + 0.65
          rows: {}
          name: inner
      rows:
        bottom: {}
        home: {}
        top: {}
      name: matrix
    col: *ref_0
    row: home
matrix_outer_top:
  x: -6.3207936
  'y': 35.8470022
  r: 10
  meta:
    stagger: 0
    spread: 18
    splay: 0
    origin:
      - 0
      - 0
    orient: 0
    shift:
      - 0
      - 0
    rotate: 0
    width: 17.5
    height: 16.5
    padding: 18.2
    autobind: 10
    skip: false
    asym: both
    colrow: outer_top
    name: matrix_outer_top
    bind:
      - 5
      - 5
      - 5
      - 5
    zone: *ref_1
    col: *ref_0
    row: top
matrix_pinky_bottom:
  x: 16.7864661
  'y': 12.2002891
  r: 8
  meta:
    stagger: 9.1
    spread: 18.65
    splay: -2
    origin:
      - 0
      - 0
    orient: 0
    shift:
      - 0
      - 0
    rotate: 0
    width: 17.5
    height: 16.5
    padding: 18.2
    autobind: 10
    skip: false
    asym: both
    colrow: pinky_bottom
    name: matrix_pinky_bottom
    bind:
      - 5
      - 5
      - 5
      - 5
    zone: *ref_1
    col: *ref_2
    row: bottom
matrix_pinky_home:
  x: 14.2535157
  'y': 30.2231679
  r: 8
  meta:
    stagger: 9.1
    spread: 18.65
    splay: -2
    origin:
      - 0
      - 0
    orient: 0
    shift:
      - 0
      - 0
    rotate: 0
    width: 17.5
    height: 16.5
    padding: 18.2
    autobind: 10
    skip: false
    asym: both
    colrow: pinky_home
    name: matrix_pinky_home
    bind:
      - 5
      - 5
      - 5
      - 5
    zone: *ref_1
    col: *ref_2
    row: home
matrix_pinky_top:
  x: 11.7205653
  'y': 48.2460468
  r: 8
  meta:
    stagger: 9.1
    spread: 18.65
    splay: -2
    origin:
      - 0
      - 0
    orient: 0
    shift:
      - 0
      - 0
    rotate: 0
    width: 17.5
    height: 16.5
    padding: 18.2
    autobind: 10
    skip: false
    asym: both
    colrow: pinky_top
    name: matrix_pinky_top
    bind:
      - 5
      - 5
      - 5
      - 5
    zone: *ref_1
    col: *ref_2
    row: top
matrix_ring_bottom:
  x: 33.3000114
  'y': 30.143149
  r: 6
  meta:
    stagger: 15.469999999999999
    spread: 18.85
    splay: -2
    origin:
      - 0
      - 0
    orient: 0
    shift:
      - 0
      - 0
    rotate: 0
    width: 17.5
    height: 16.5
    padding: 18.2
    autobind: 10
    skip: false
    asym: both
    colrow: ring_bottom
    name: matrix_ring_bottom
    bind:
      - 5
      - 5
      - 5
      - 5
    zone: *ref_1
    col: *ref_3
    row: bottom
matrix_ring_home:
  x: 31.3975934
  'y': 48.2434475
  r: 6
  meta:
    stagger: 15.469999999999999
    spread: 18.85
    splay: -2
    origin:
      - 0
      - 0
    orient: 0
    shift:
      - 0
      - 0
    rotate: 0
    width: 17.5
    height: 16.5
    padding: 18.2
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
    colrow: inner_home
    name: matrix_inner_home
    bind:
      - 5
      - 5
      - 5
      - 5
    zone: *ref_1
    col: *ref_6
    row: home
matrix_inner_top:
  x: 89.0056004
  'y': 65.881571
  r: 0
  meta:
    stagger: -6.369999999999999
    spread: 18.65
    splay: -2
    origin:
      - 0
      - 0
    orient: 0
    shift:
      - 0
      - 0
    rotate: 0
    width: 17.5
    height: 16.5
    padding: 18.2
    autobind: 10
    skip: false
    asym: both
    colrow: inner_top
    name: matrix_inner_top
    bind:
      - 5
      - 5
      - 5
      - 5
    zone: *ref_1
    col: *ref_6
    row: top
fan_near_thumb:
  x: 71.1609251
  'y': 6.0945541
  r: 10
  meta:
    stagger: 0
    spread: 19
    splay: 0
    origin:
      - -9
      - -9.1
    orient: 0
    shift:
      - 0
      - 0
    rotate: 0
    width: 17.5
    height: 16.5
    padding: 19
    autobind: 10
    skip: false
    asym: both
    colrow: near_thumb
    name: fan_near_thumb
    bind:
      - 5
      - 5
      - 5
      - 5
    zone: &ref_8
      columns:
        near: &ref_7
          key:
            origin:
              - '-mx/2'
              - '-my/2'
            rotate: 0
          rows: {}
          name: near
        home: &ref_9
          key:
            splay: -25
            spread: 1.1mx
            origin:
              - '-mx/2'
              - '-my/2'
            shift:
              - 0
              - 0my
          rows: {}
          name: home
        far: &ref_10
          key:
            splay: -25
            rotate: 0
            spread: 1.1mx
            origin:
              - '-mx/2'
              - '-my/2'
            shift:
              - '-0mx'
              - 0my
          rows: {}
          name: far
      rows:
        thumb: {}
      name: fan
    col: *ref_7
    row: thumb
fan_home_thumb:
  x: 94.4256329
  'y': 5.4687576
  r: -15
  meta:
    stagger: 0
    spread: 19.8
    splay: -25
    origin:
      - -9
      - -9.1
    orient: 0
    shift:
      - 0
      - 0
    rotate: 0
    width: 17.5
    height: 16.5
    padding: 19
    autobind: 10
    skip: false
    asym: both
    colrow: home_thumb
    name: fan_home_thumb
    bind:
      - 5
      - 5
      - 5
      - 5
    zone: *ref_8
    col: *ref_9
    row: thumb
fan_far_thumb:
  x: 115.2461459
  'y': -4.9304973
  r: -40
  meta:
    stagger: 0
    spread: 19.8
    splay: -25
    origin:
      - -9
      - -9.1
    orient: 0
    shift:
      - -0.0
      - 0
    rotate: 0
    width: 17.5
    height: 16.5
    padding: 19
    autobind: 10
    skip: false
    asym: both
    colrow: far_thumb
    name: fan_far_thumb
    bind:
      - 5
      - 5
      - 5
      - 5
    zone: *ref_8
    col: *ref_10
    row: thumb
