michaelrommel/nightliner/(commit log)

2023-10-23 feat: first version of schematics
    [nightliner.csv, nightliner.kicad_pcb, nightliner.kicad_sch]
2023-10-23 feat: schematics with partial footprints
    [nightliner.kicad_pcb, nightliner.kicad_sch]
2023-10-23 feat: first PCB placement
    [nightliner.kicad_pcb, nightliner.kicad_sch]
2023-10-25 feat: PCB placement (with wrong choc pos)
    [debug.dxf, keycaps.dxf, nightliner-Switchplate.3mf, nightliner-Switchplate.stl, nightliner.FCStd, nightliner.kicad_pcb, nightliner.kicad_sch, pcb.dxf]
2023-10-25 feat: routed PCB, ready for fills
    [debug.dxf, nightliner.kicad_pcb, nightliner.kicad_sch, pcb.dxf, plate.dxf, stack.dxf, stack_pcb.dxf, stack_plate.dxf]
2023-10-26 fix: DRC errors, updated footprints
    [nightliner.kicad_pcb, nightliner.kicad_sch]
2023-10-26 feat: add mounting holes, better labels
    [nightliner.kicad_pcb, nightliner.kicad_sch]
2023-10-26 feat: change connector and on/off switch, re-layout
    [nightliner.csv, nightliner.kicad_pcb, nightliner.kicad_sch, plate.dxf, stack_plate.dxf, switchplate.dxf, switchplate_recess.dxf]
2023-10-28 fix: footprint for prog header, mounting holes, drc check
    [nightliner.kicad_pcb, nightliner.kicad_sch]
2023-10-30 feat: move all outlines to KiCAD, update footprints
    [3Pins SPDT switch SK-12D07 1P2T.iges, Choc.FCStd, Holyiot18010.step, Kailh_Choc_CPG135001D02-old.step, Kailh_Choc_CPG135001D02-somewhatold.step, Kailh_Choc_CPG135001D02.step, Kailh_Hotswap_Socket_PG1350.step, nightliner.kicad_pcb]
2023-10-31 feat: case for the keyboard
    [nightliner-case-left.stl, nightliner.kicad_pcb, nightliner.kicad_sch, test-1.FCStd]
2023-10-31 fix: move battery connector to top
    [nightliner.kicad_pcb]
2023-11-01 fix: add 0.2mm offset for case clearance
    [nightliner.kicad_pcb]
2023-11-02 feat: add split pogo connector, reroute board
    [female-pogo-6pin.iges, female-pogo-6pin.step, nightliner.kicad_pcb, nightliner.kicad_sch, pogo-connector-female-6.FCStd]
2023-11-02 fix: move mag connector up, preserve wall thickness of case
    [nightliner.kicad_pcb, pogo-connector-female-6.FCStd]
2023-11-04 feat: create right side pcb, clean up footprints
    [LiPo_502540.step, Litio_502540.FCStd, Litio_523450.FCStd, female-pogo-6pin-left.step, female-pogo-6pin-right.step, female-pogo-6pin.iges, female-pogo-6pin.step, nightliner-B_Silkscreen.dxf]
2023-11-06 fix: make sides symmetric
    [nightliner.kicad_pcb, nightliner.kicad_sch]
2023-11-07 feat: initial right side case completed
    [Kailh_Choc_CPG135001D02-brown.FCStd, Kailh_Choc_CPG135001D02-brown.step, nightliner-B_Silkscreen.dxf, nightliner-Edge_Cuts.dxf, nightliner-F_Silkscreen.dxf, nightliner-User_1.dxf, nightliner-User_2.dxf, nightliner-User_3.dxf]
2023-11-09 fix: change edge outline, flip switches
    [nightliner.kicad_pcb, nightliner.kicad_sch]
2023-11-14 feat: outline change, fix right pinky column
    [nightliner-B_Silkscreen.dxf, nightliner-Edge_Cuts.dxf, nightliner-F_Silkscreen.dxf, nightliner-Switchplate.3mf, nightliner-User_2.dxf, nightliner-User_3.dxf, nightliner-User_4.dxf, nightliner-User_5.dxf]
2023-11-23 fix: rework right case, fix outline
    [nightliner-F_Silkscreen.dxf, nightliner-User_2.dxf, nightliner-User_3.dxf, nightliner-User_4.dxf, nightliner-User_5.dxf, nightliner-User_Drawings.dxf, nightliner.kicad_pcb]
2023-12-03 fix: final version, create production gerbers
    [BOM-nightliner.csv, nightliner-B_Silkscreen.dxf, nightliner-F_Silkscreen.dxf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]
